rbarbier-p/Harmora/README.md

### Things to improve PCB:

- Tiny Leds for status, power, reading/writing
- expose more pins 
- thicker lines if we have the space
