rbarbier-p/Harmora/presentation.md

Presentation du projet: idees/envies et ce que ca implique
software vs hardware ()
limitation, problemes recontres et solutions (limitation materiel: mcu, library)
ce qu'on a appris (design pcb, realisation d'un cahier des charges, modelisation 3D, decoupe laser, soudure, design d'un produit, realisation d'un projet de 0)
evolution de competences?

Resentit et experience 
ce qu'on souhaite faire plus tard ? / suite du projet ou profesionnalisation

Slide 1: qui/quoi ? -> presentation du projet harmora, et du group rene un etudiant de 42 barcelone qui est venu a paris specialement pour faire ce module.
Slide 2: pourquoi on a choisis ce projet -> theorie musicale (solfege) c'est un domaine assez complique (lie au mathematique et donc  a l'informatique)
-> meme quand on connait la theorie il faut encore beaucoup de pratique pour pouvoir jouer d'un instrument
Slide 3: idea/projet -> notre idee c'est de creer un controlleur midi, et plus precisement un generateur d'accords. Qui permet de facilement jouer des progression d'accord ditent diatonique qui suivent des regles d'harmonie musicale, avec differents instruments. MIDI est une norme et un protocol de communication pour les instrument de musique 
Slide 4: software/hardware -> Notre projet est plutot equilibre entre hardware et software...
Slide 5: problemes/limitations -> pour nous la plus grosse limitation c'est l'utilisation des atmega, RAM limite assez rapidement
Slide 6: ce qu'on a appris -> le design de pcb en utilisant KiCad, ca permet de creer un circuit imprime pour n'importe quel produit/object electronique.
Slide 7: La modelisation 3d qui peut servir pour imprimer en 3D mais aussi pour decouper/engraver avec une decoupeuse laser. C'est tres utile pour tester et prototyper.
Slide 8: autres skills qu'on a appris: la sourdure bien evidement, mais aussi la redaction d'un cahier des charges et on a appris a design un produit de A a Z.
Slide 9: apres le project/suite -> version 2, ameliore ? le commercialiser ?
