rbarbier-p/Harmora/3Dmodels/caseTop4(1).dxf

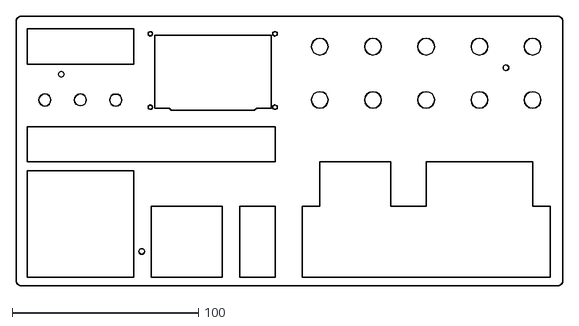
[picture p1: CAD file, 2026-05-14]
3Dmodels/caseTop4(1).dxf
293.7 x 144.7
