rbarbier-p/Harmora/3Dmodels/switch_grid-modes.stl

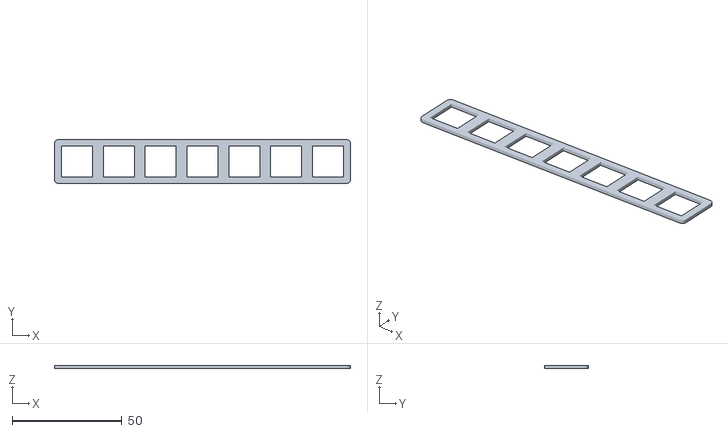
[picture p2: CAD file, 2026-04-30]
3Dmodels/switch_grid-modes.stl
134.8 x 19.9 x 1.50
