rbarbier-p/Harmora/3Dmodels/switch_grid-modifier.stl

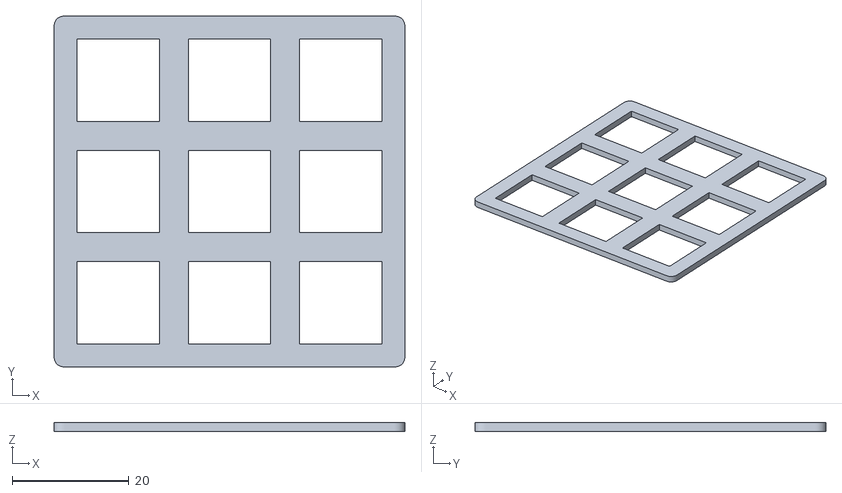
[picture p3: CAD file, 2026-04-30]
3Dmodels/switch_grid-modifier.stl
60.0 x 60.0 x 1.50
