rbarbier-p/Harmora/3Dmodels/case-top.dxf

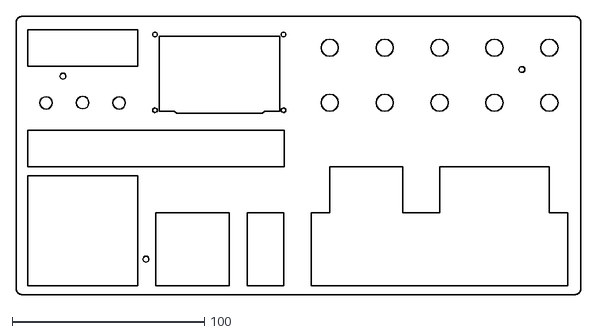
[picture p4: CAD file, 2026-04-30]
3Dmodels/case-top.dxf
293.7 x 144.7
