rbarbier-p/Harmora/3Dmodels/switch_grid-piano.stl

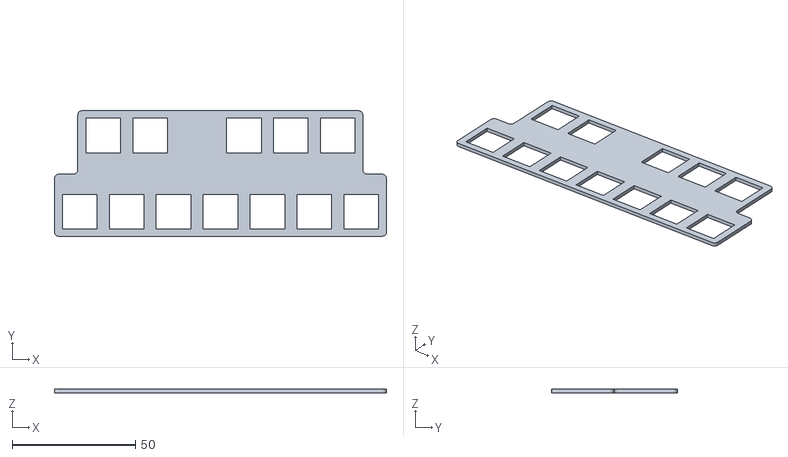
[picture p5: CAD file, 2026-04-30]
3Dmodels/switch_grid-piano.stl
134.8 x 51.0 x 1.50
