rbarbier-p/Harmora/3Dmodels/case-bottom.stl

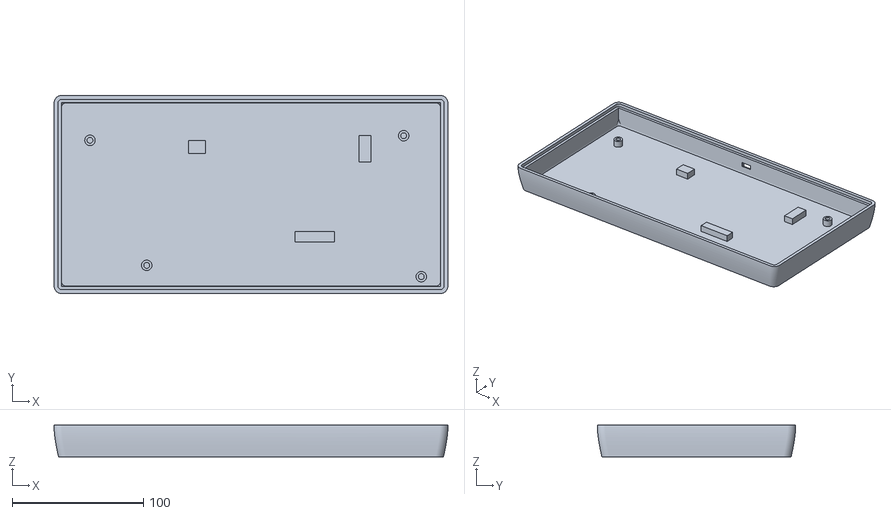
[picture p6: CAD file, 2026-04-30]
3Dmodels/case-bottom.stl
300.0 x 151.0 x 24.0
