rbarbier-p/Harmora/3Dmodels/inner_separators.stl

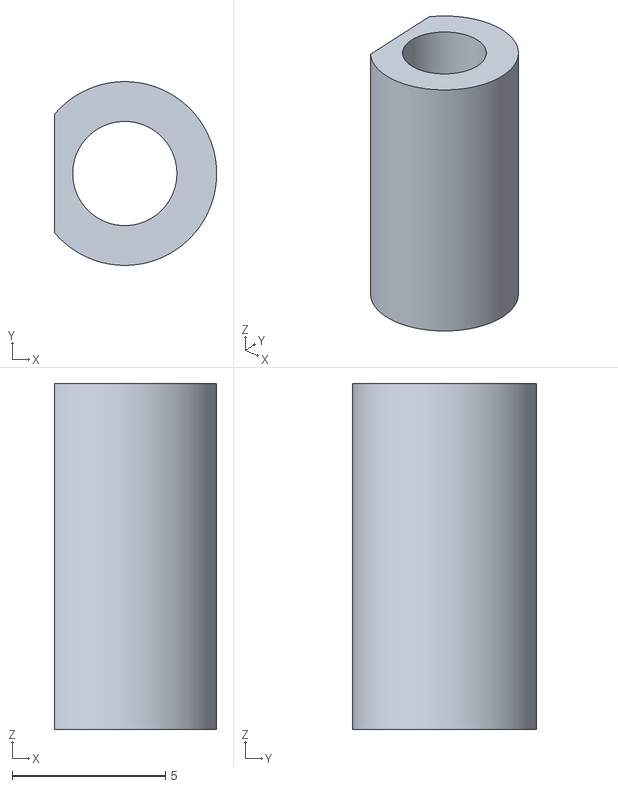
[picture p7: CAD file, 2026-04-30]
3Dmodels/inner_separators.stl
5.30 x 6.00 x 11.3
