rbarbier-p/Harmora/3Dmodels/switch_grid-looper.stl

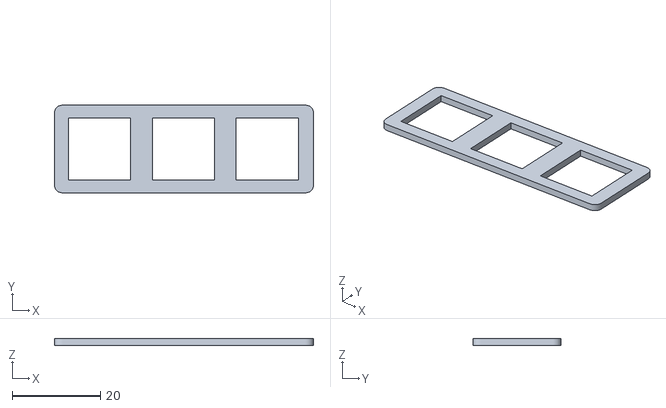
[picture p8: CAD file, 2026-04-30]
3Dmodels/switch_grid-looper.stl
58.9 x 19.9 x 1.50
