rbarbier-p/Harmora/PCB/Harmora.kicad_pcb

## KiCad design PCB/Harmora.kicad_pcb (2026-04-13)

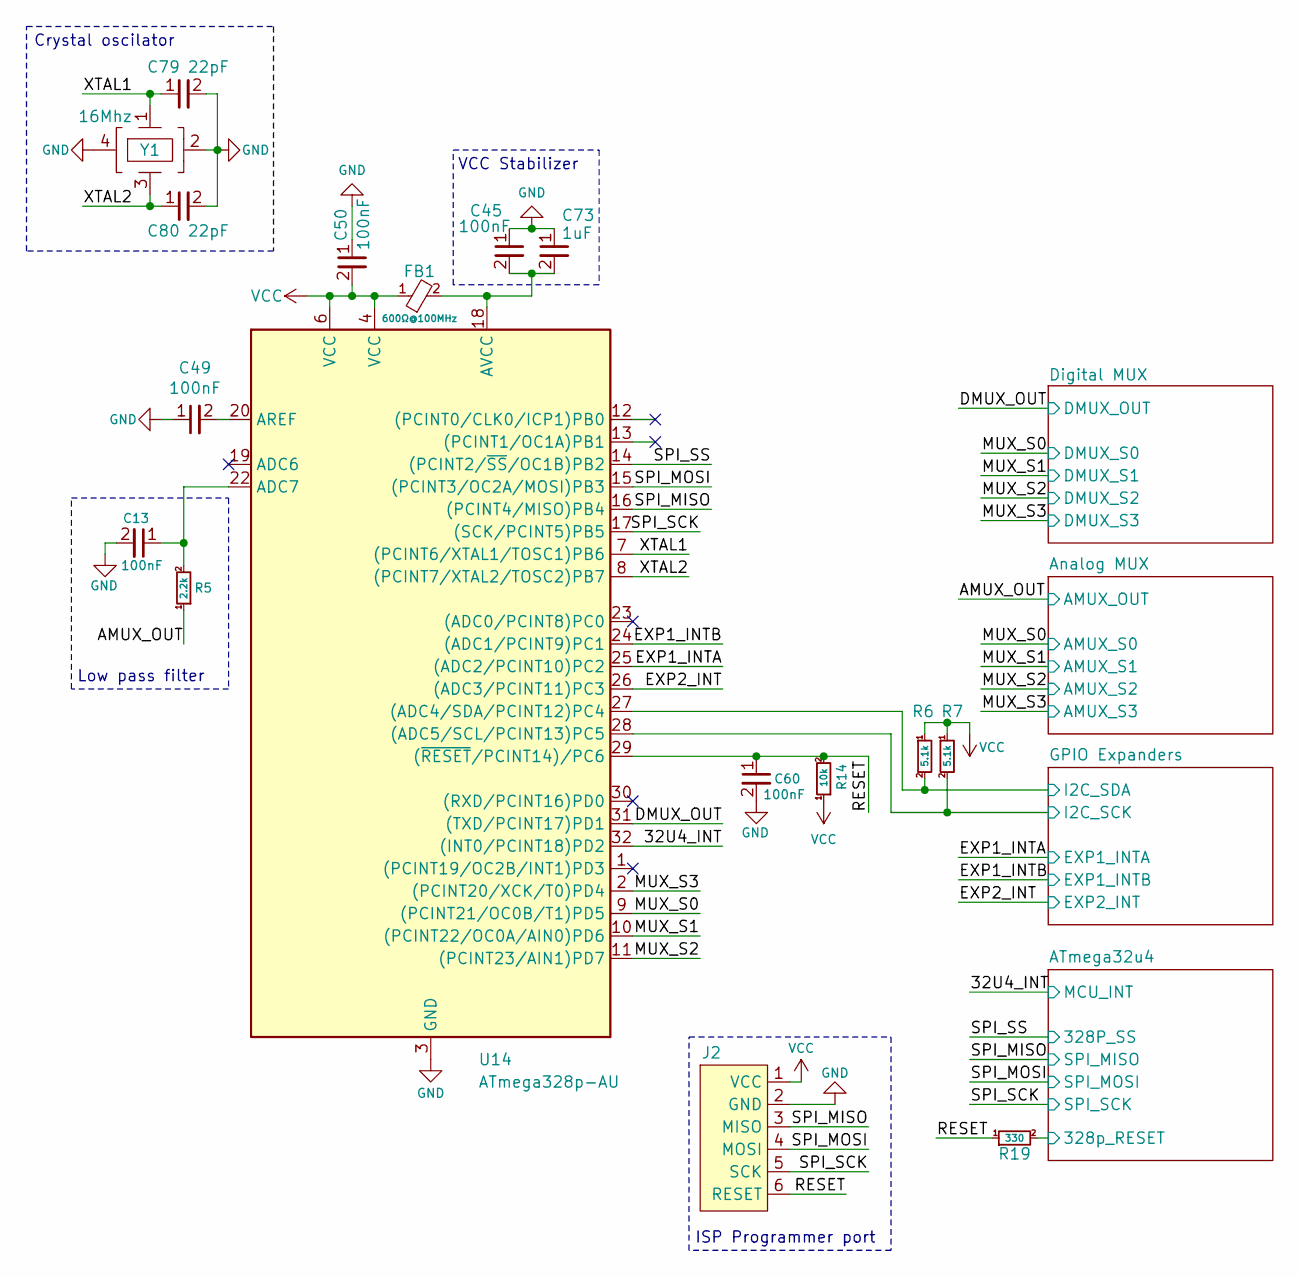
[picture p9: schematic Harmora.kicad_sch]

Parts:
C13, C45, C49, C50, C60: 100nF; 0603_C
C73: 1uF; 0603_C
C79, C80: 22pF; 0603_C
FB1: 600Ω@100MHz; 0603_FB
J2: ISP port
R5: 2.2k; 0603_R
R6, R7: 5.1k; 0603_R
R14: 10k; 0603_R
R19: 330; 0603_R
U14: ATmega328p-AU; ATMEGA328P-AU
Y1: 16Mhz; Crystal Oscillator 16MHz

Connections:
/32U4_INT: U14.32 ((INT0/PCINT18)PD2); also elsewhere on the board
/AMUX_OUT: R5.1; also elsewhere on the board
/ATmega32u4/328p_RESET: R19.2; also elsewhere on the board
/DMUX_OUT: U14.31 ((TXD/PCINT17)PD1); also elsewhere on the board
/EXP1_INTA: U14.25 ((ADC2/PCINT10)PC2); also elsewhere on the board
/EXP1_INTB: U14.24 ((ADC1/PCINT9)PC1); also elsewhere on the board
/EXP2_INT: U14.26 ((ADC3/PCINT11)PC3); also elsewhere on the board
/GPIO Expanders/I2C_SCK: R7.2, U14.28 ((ADC5/SCL/PCINT13)PC5); also elsewhere on the board
/GPIO Expanders/I2C_SDA: R6.2, U14.27 ((ADC4/SDA/PCINT12)PC4); also elsewhere on the board
/MUX_S0: U14.9 ((PCINT21/OC0B/T1)PD5); also elsewhere on the board
/MUX_S1: U14.10 ((PCINT22/OC0A/AIN0)PD6); also elsewhere on the board
/MUX_S2: U14.11 ((PCINT23/AIN1)PD7); also elsewhere on the board
/MUX_S3: U14.2 ((PCINT20/XCK/T0)PD4); also elsewhere on the board
/RESET: C60.1, J2.6 (RESET), R14.2, R19.1, U14.29 ((~RESET/PCINT14)/PC6)
/SPI_MISO: J2.3 (MISO), U14.16 ((PCINT4/MISO)PB4); also elsewhere on the board
/SPI_SS: U14.14 ((PCINT2/~SS/OC1B)PB2); also elsewhere on the board
/XTAL1: C79.1, U14.7 ((PCINT6/XTAL1/TOSC1)PB6), Y1.1
/XTAL2: C80.1, U14.8 ((PCINT7/XTAL2/TOSC2)PB7), Y1.3
GND: C13.2, C45.1, C49.1, C50.1, C60.2, C73.1, C79.2, C80.2, J2.2 (GND), U14.3 (GND), Y1.2, Y1.4; also elsewhere on the board
unnamed: C13.1, R5.2, U14.22 (ADC7)
unnamed: C49.2, U14.20 (AREF)
unnamed: C45.2, C73.2, FB1.2, U14.18 (AVCC)
VCC: C50.2, FB1.1, J2.1 (VCC), R6.1, R7.1, R14.1, U14.4 (VCC), U14.6 (VCC); also elsewhere on the board

Notes on the sheet:
ISP Programmer port
Crystal oscilator
Low pass filter
VCC Stabilizer

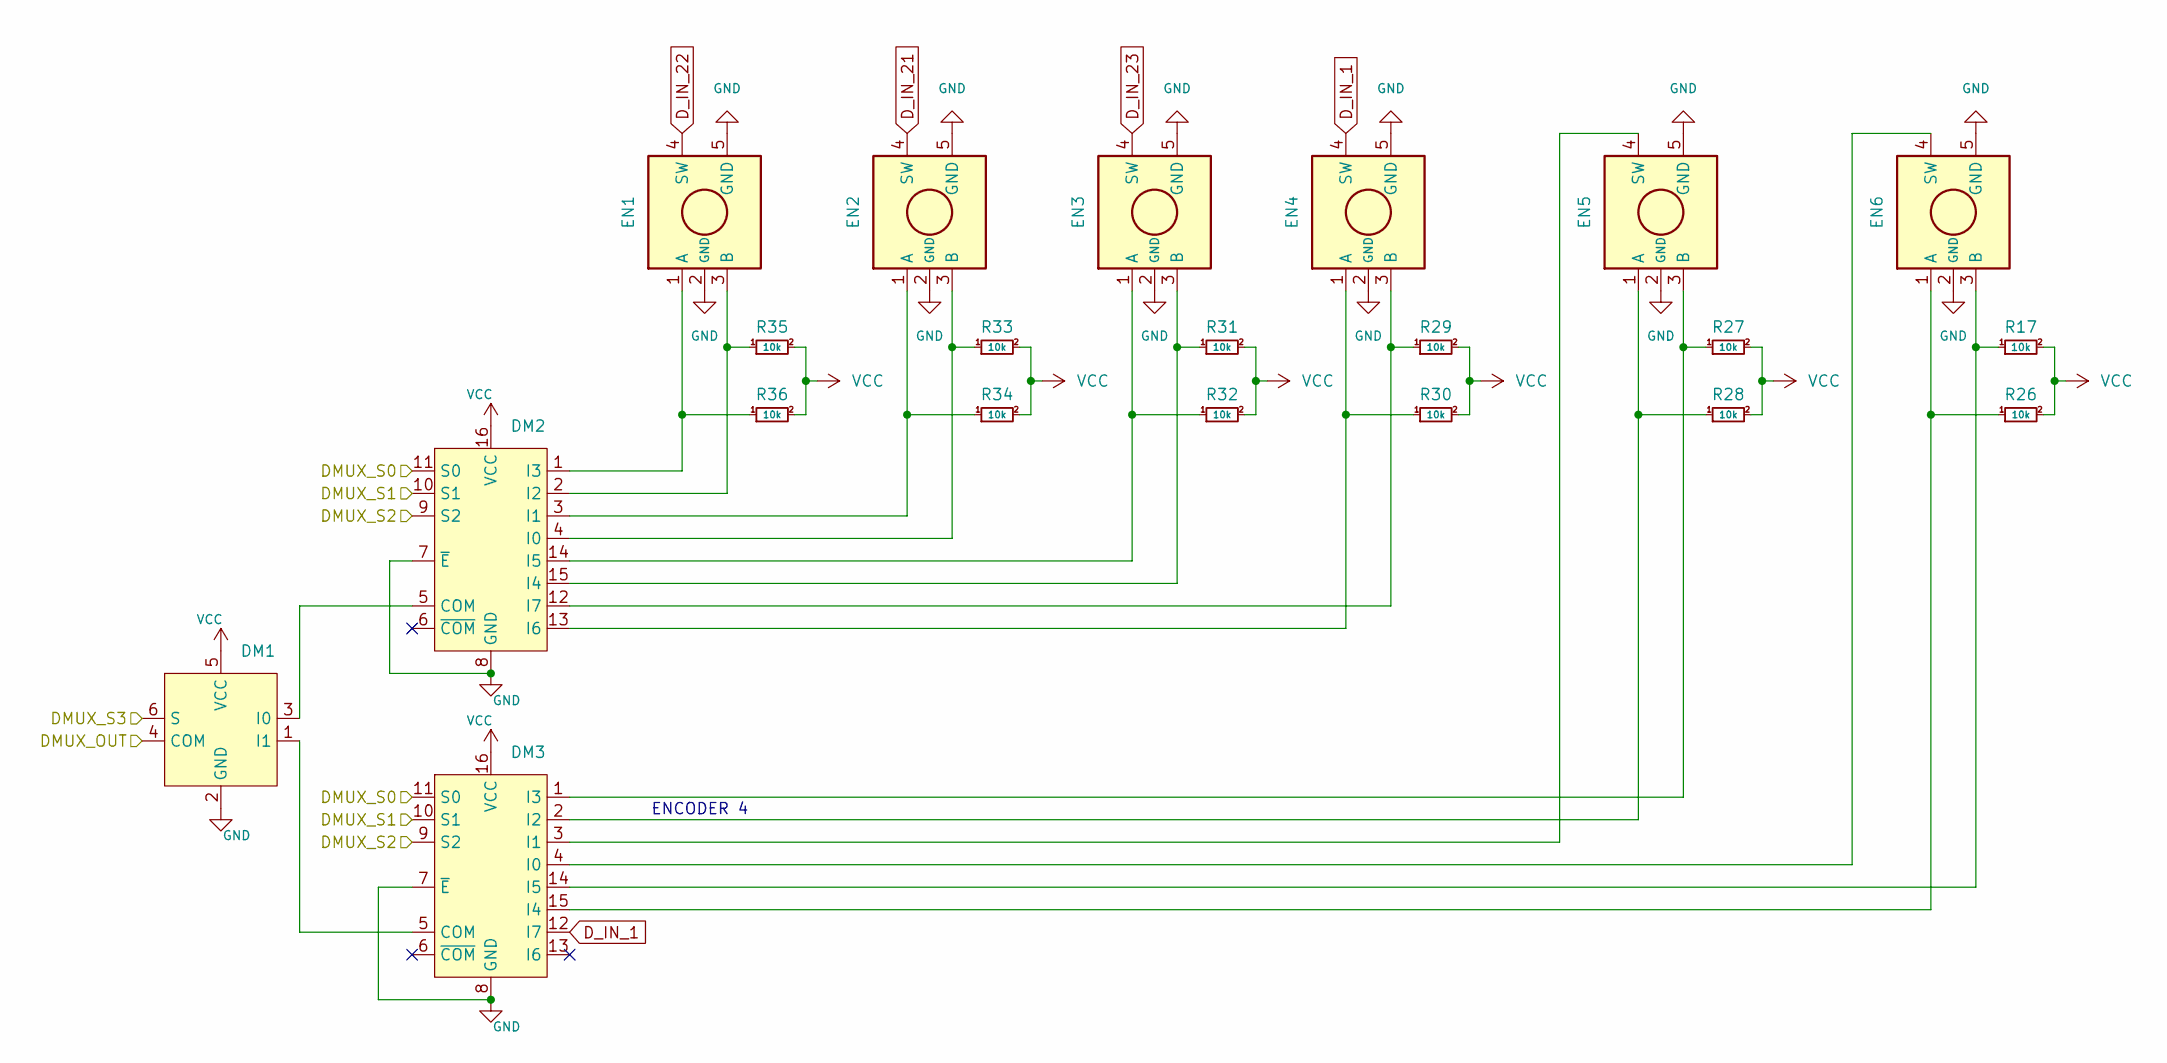
[picture p10: schematic digital_mux.kicad_sch]

Parts:
DM1: 74LVC1G157; 74LVC1G157 SOT-363 2_1 MUX
DM2, DM3: 74AC151SC; 74AC151SC SOIC-16 8_1 MUX
EN1, EN2, EN3, EN4, EN5, EN6: Rotary Encoder EC11E
R17, R26, R27, R28, R29, R30, R31, R32, R33, R34, R35, R36: 10k; 0603_R

Connections:
/DMUX_OUT: DM1.4 (COM); also elsewhere on the board
/MUX_S0: DM2.11 (S0), DM3.11 (S0); also elsewhere on the board
/MUX_S1: DM2.10 (S1), DM3.10 (S1); also elsewhere on the board
/MUX_S2: DM2.9 (S2), DM3.9 (S2); also elsewhere on the board
/MUX_S3: DM1.6 (S); also elsewhere on the board
D_IN_1: DM3.12 (I7), EN4.4 (SW)
D_IN_21: EN2.4 (SW); also elsewhere on the board
D_IN_22: EN1.4 (SW); also elsewhere on the board
D_IN_23: EN3.4 (SW); also elsewhere on the board
GND: DM1.2 (GND), DM2.7 (~E), DM2.8 (GND), DM3.7 (~E), DM3.8 (GND), EN1.2 (GND), EN1.5 (GND), EN2.2 (GND), EN2.5 (GND), EN3.2 (GND), EN3.5 (GND), EN4.2 (GND), EN4.5 (GND), EN5.2 (GND), EN5.5 (GND), EN6.2 (GND), EN6.5 (GND); also elsewhere on the board
unnamed: DM1.3 (I0), DM2.5 (COM)
unnamed: DM1.1 (I1), DM3.5 (COM)
unnamed: DM2.4 (I0), EN2.3 (B), R33.1
unnamed: DM2.3 (I1), EN2.1 (A), R34.1
unnamed: DM2.2 (I2), EN1.3 (B), R35.1
unnamed: DM2.1 (I3), EN1.1 (A), R36.1
unnamed: DM2.15 (I4), EN3.3 (B), R31.1
unnamed: DM2.14 (I5), EN3.1 (A), R32.1
unnamed: DM2.13 (I6), EN4.1 (A), R30.1
unnamed: DM2.12 (I7), EN4.3 (B), R29.1
unnamed: DM3.4 (I0), EN6.4 (SW)
unnamed: DM3.3 (I1), EN5.4 (SW)
unnamed: DM3.2 (I2), EN5.1 (A), R28.1
unnamed: DM3.1 (I3), EN5.3 (B), R27.1
unnamed: DM3.15 (I4), EN6.1 (A), R26.1
unnamed: DM3.14 (I5), EN6.3 (B), R17.1
VCC: DM1.5 (VCC), DM2.16 (VCC), DM3.16 (VCC), R17.2, R26.2, R27.2, R28.2, R29.2, R30.2, R31.2, R32.2, R33.2, R34.2, R35.2, R36.2; also elsewhere on the board

Notes on the sheet:
ENCODER 4

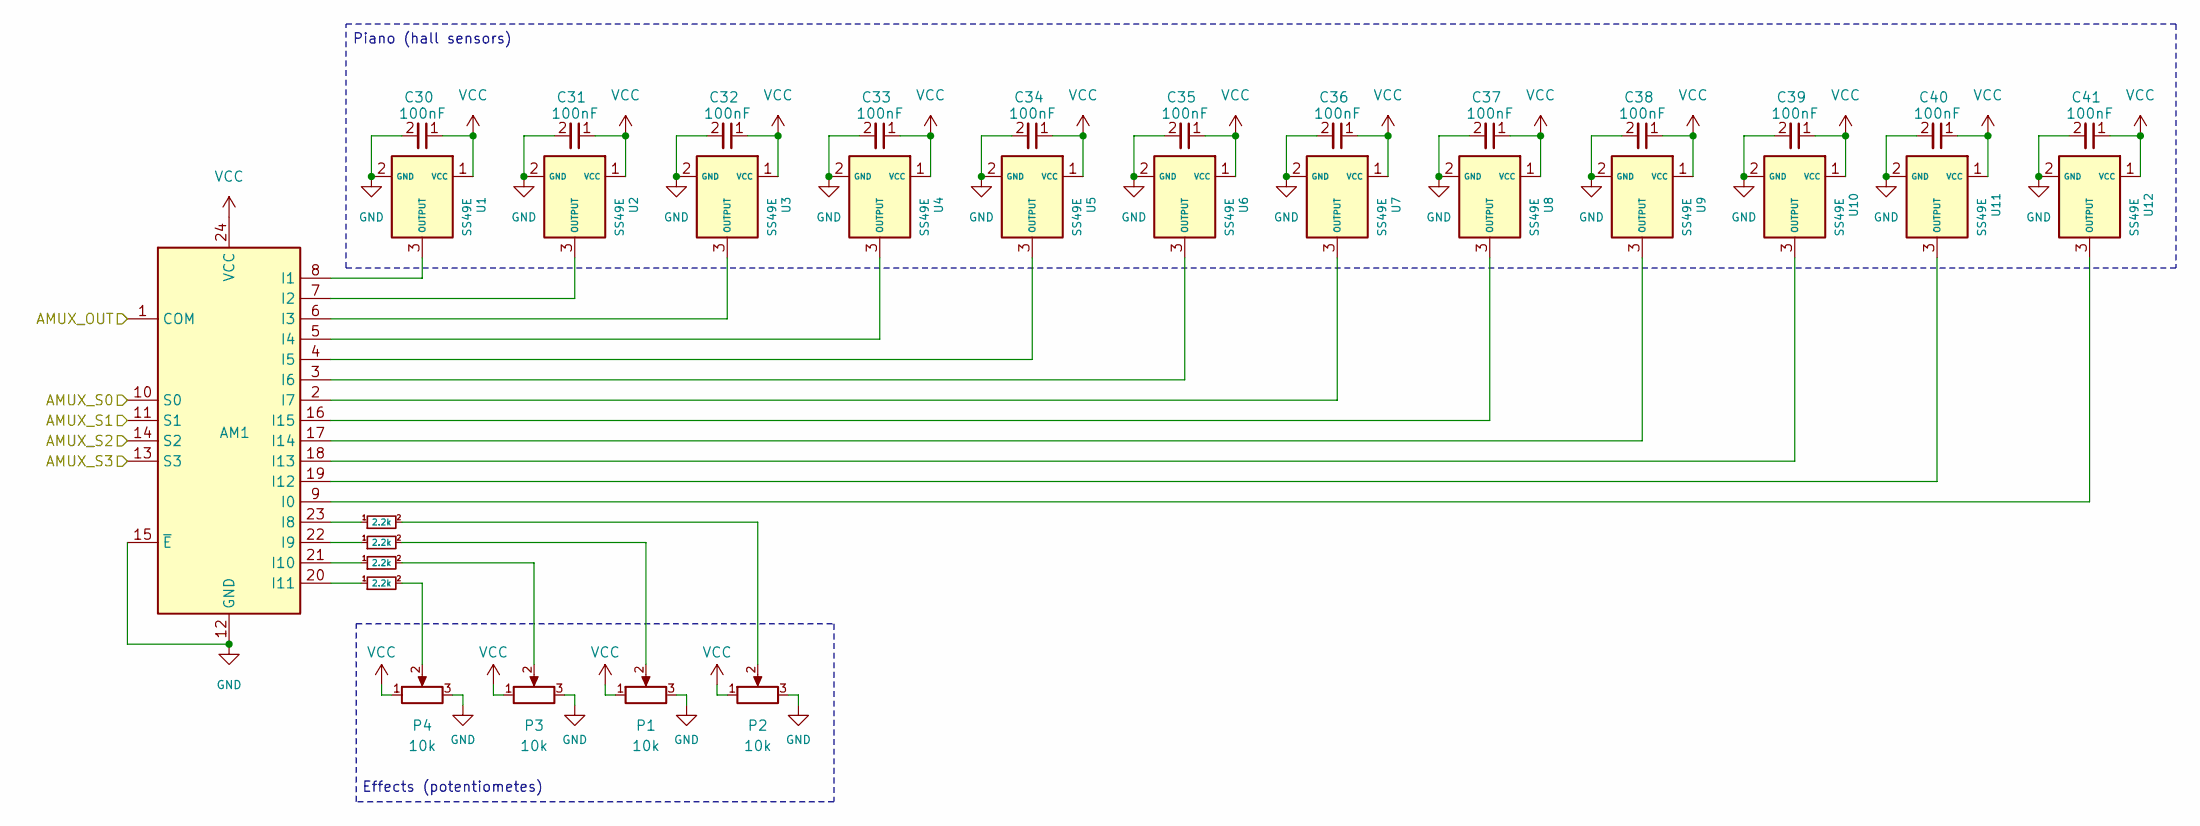
[picture p11: schematic analog_mux.kicad_sch]

Parts:
AM1: CD74HC4067M; CD74HC4067M Analog Mux (SOIC-24)
C30, C31, C32, C33, C34, C35, C36, C37, C38, C39, C40, C41: 100nF; 0603_C
P1, P2, P3, P4: 10k; Rotary Potentiometer RK09
R1, R2, R3, R4: 2.2k; 0603_R
U1, U2, U3, U4, U5, U6, U7, U8, U9, U10, U11, U12: SS49E; SLSS49E-3 Hall Sensor (SOT-23-3)

Connections:
/AMUX_OUT: AM1.1 (COM); also elsewhere on the board
/MUX_S0: AM1.10 (S0); also elsewhere on the board
/MUX_S1: AM1.11 (S1); also elsewhere on the board
/MUX_S2: AM1.14 (S2); also elsewhere on the board
/MUX_S3: AM1.13 (S3); also elsewhere on the board
GND: AM1.12 (GND), AM1.15 (~E), C30.2, C31.2, C32.2, C33.2, C34.2, C35.2, C36.2, C37.2, C38.2, C39.2, C40.2, C41.2, P1.3, P2.3, P3.3, P4.3, U1.2 (GND), U2.2 (GND), U3.2 (GND), U4.2 (GND), U5.2 (GND), U6.2 (GND), U7.2 (GND), U8.2 (GND), U9.2 (GND), U10.2 (GND), U11.2 (GND), U12.2 (GND); also elsewhere on the board
unnamed: AM1.9 (I0), U12.3 (OUTPUT)
unnamed: AM1.8 (I1), U1.3 (OUTPUT)
unnamed: AM1.7 (I2), U2.3 (OUTPUT)
unnamed: AM1.6 (I3), U3.3 (OUTPUT)
unnamed: AM1.5 (I4), U4.3 (OUTPUT)
unnamed: AM1.4 (I5), U5.3 (OUTPUT)
unnamed: AM1.3 (I6), U6.3 (OUTPUT)
unnamed: AM1.2 (I7), U7.3 (OUTPUT)
unnamed: AM1.23 (I8), R4.1
unnamed: AM1.22 (I9), R3.1
unnamed: AM1.21 (I10), R2.1
unnamed: AM1.20 (I11), R1.1
unnamed: AM1.19 (I12), U11.3 (OUTPUT)
unnamed: AM1.18 (I13), U10.3 (OUTPUT)
unnamed: AM1.17 (I14), U9.3 (OUTPUT)
unnamed: AM1.16 (I15), U8.3 (OUTPUT)
unnamed: P1.2, R3.2
unnamed: P2.2, R4.2
unnamed: P3.2, R2.2
unnamed: P4.2, R1.2
VCC: AM1.24 (VCC), C30.1, C31.1, C32.1, C33.1, C34.1, C35.1, C36.1, C37.1, C38.1, C39.1, C40.1, C41.1, P1.1, P2.1, P3.1, P4.1, U1.1 (VCC), U2.1 (VCC), U3.1 (VCC), U4.1 (VCC), U5.1 (VCC), U6.1 (VCC), U7.1 (VCC), U8.1 (VCC), U9.1 (VCC), U10.1 (VCC), U11.1 (VCC), U12.1 (VCC); also elsewhere on the board

Notes on the sheet:
Piano (hall sensors)
Effects (potentiometes)

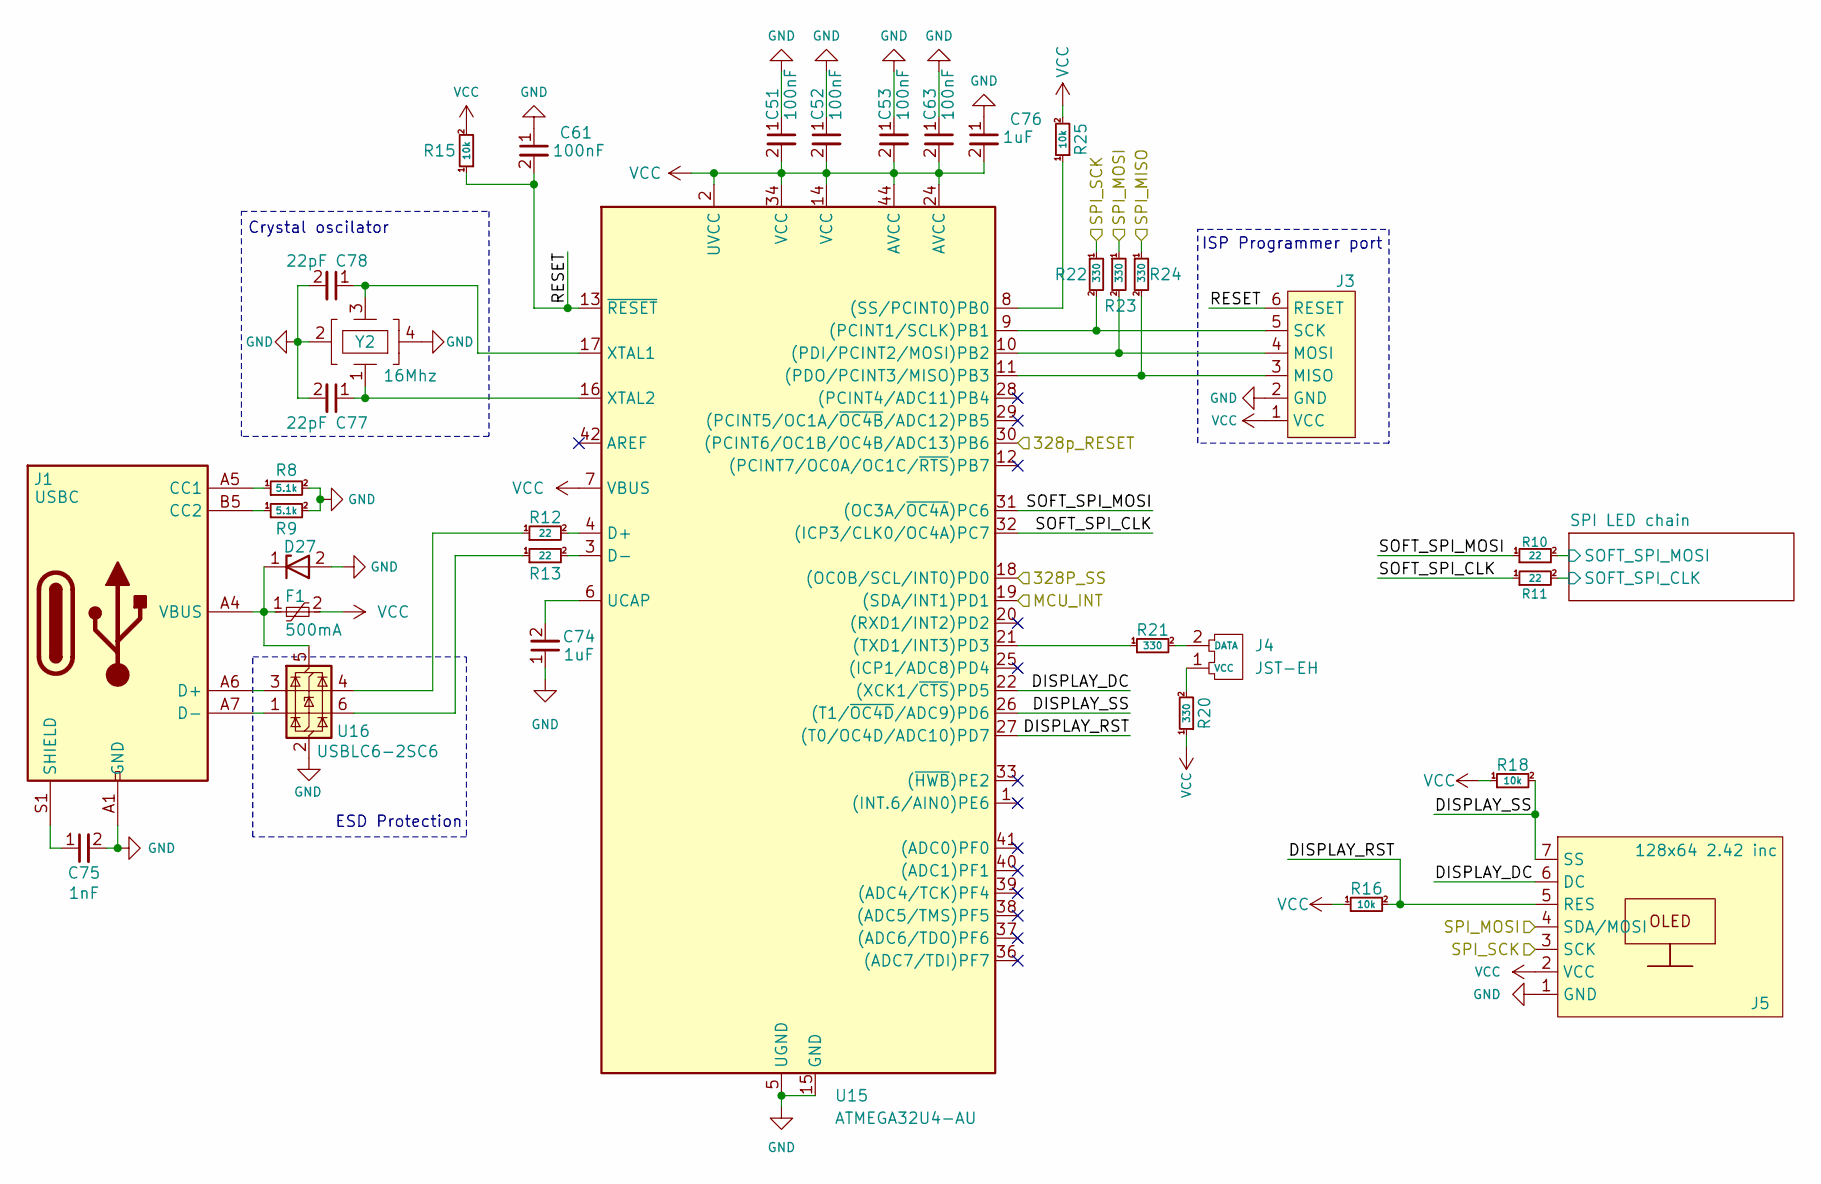
[picture p12: schematic MCU_32u4.kicad_sch]

Parts:
C51, C52, C53, C61, C63: 100nF; 0603_C
C74, C76: 1uF; 0603_C
C75: 1nF; 0603_C
C77, C78: 22pF; 0603_C
D27: TVS Diode SOD-123FL
F1: 500mA; Resettable Fuse 1206
J1: USBC; USB C Receptacle USB2.0 16PIN
J3: ISP port
J4: JST-EH; JST-EH port
J5: 128x64 2.42 inc; SPI Screen PinHeader
R8, R9: 5.1k; 0603_R
R10, R11, R12, R13: 22; 0603_R
R15, R16, R18, R25: 10k; 0603_R
R20, R21, R22, R23, R24: 330; 0603_R
U15: ATMEGA32U4-AU
U16: USBLC6-2SC6; ESD Prot SOT-23-6
Y2: 16Mhz; Crystal Oscillator 16MHz

Connections:
/32U4_INT: U15.19 ((SDA/INT1)PD1); also elsewhere on the board
/ATmega32u4/328p_RESET: U15.30 ((PCINT6/OC1B/OC4B/ADC13)PB6); also elsewhere on the board
/ATmega32u4/DISPLAY_DC: J5.6 (DC), U15.22 ((XCK1/~CTS)PD5)
/ATmega32u4/DISPLAY_RST: J5.5 (RES), R16.2, U15.27 ((T0/OC4D/ADC10)PD7)
/ATmega32u4/DISPLAY_SS: J5.7 (SS), R18.2, U15.26 ((T1/~OC4D/ADC9)PD6)
/ATmega32u4/RESET: C61.2, J3.6 (RESET), R15.1, U15.13 (~RESET)
/ATmega32u4/SOFT_SPI_CLK: R11.1, U15.32 ((ICP3/CLK0/OC4A)PC7)
/ATmega32u4/SOFT_SPI_MOSI: R10.1, U15.31 ((OC3A/~OC4A)PC6)
/ATmega32u4/SPI LED chain/SOFT_SPI_CLK: R11.2; also elsewhere on the board
/ATmega32u4/SPI LED chain/SOFT_SPI_MOSI: R10.2; also elsewhere on the board
/SPI_MISO: R24.1; also elsewhere on the board
/SPI_SS: U15.18 ((OC0B/SCL/INT0)PD0); also elsewhere on the board
GND: C51.1, C52.1, C53.1, C61.1, C63.1, C74.1, C75.2, C76.1, C77.2, C78.2, D27.2, J1.A1 (GND), J1.A12 (GND), J1.B1 (GND), J1.B12 (GND), J3.2 (GND), J5.1 (GND), R8.2, R9.2, U15.5 (UGND), U15.15 (GND), U16.2 (GND), Y2.2, Y2.4; also elsewhere on the board
unnamed: J1.A5 (CC1), R8.1
unnamed: J1.B5 (CC2), R9.1
unnamed: J1.A6 (D+), U16.3 (I/O1)
unnamed: J1.A7 (D-), U16.1 (I/O2)
unnamed: C75.1, J1.S1 (SHIELD)
unnamed: D27.1, F1.1, J1.A4 (VBUS), U16.5 (VBUS)
unnamed: J3.3 (MISO), R24.2, U15.11 ((PDO/PCINT3/MISO)PB3)
unnamed: J4.2 (DATA), R21.2
unnamed: J4.1 (VCC), R20.2
unnamed: R12.1, U16.4 (I/O1)
unnamed: R13.1, U16.6 (I/O2)
unnamed: R25.1, U15.8 ((SS/PCINT0)PB0)
unnamed: R21.1, U15.21 ((TXD1/INT3)PD3)
unnamed: R12.2, U15.4 (D+)
unnamed: R13.2, U15.3 (D-)
unnamed: C74.2, U15.6 (UCAP)
unnamed: C78.1, U15.17 (XTAL1), Y2.3
unnamed: C77.1, U15.16 (XTAL2), Y2.1
VCC: C51.2, C52.2, C53.2, C63.2, C76.2, F1.2, J3.1 (VCC), J5.2 (VCC), R15.2, R16.1, R18.1, R20.1, R25.2, U15.2 (UVCC), U15.7 (VBUS), U15.14 (VCC), U15.24 (AVCC), U15.34 (VCC), U15.44 (AVCC); also elsewhere on the board

Notes on the sheet:
ISP Programmer port
ESD Protection
Crystal oscilator

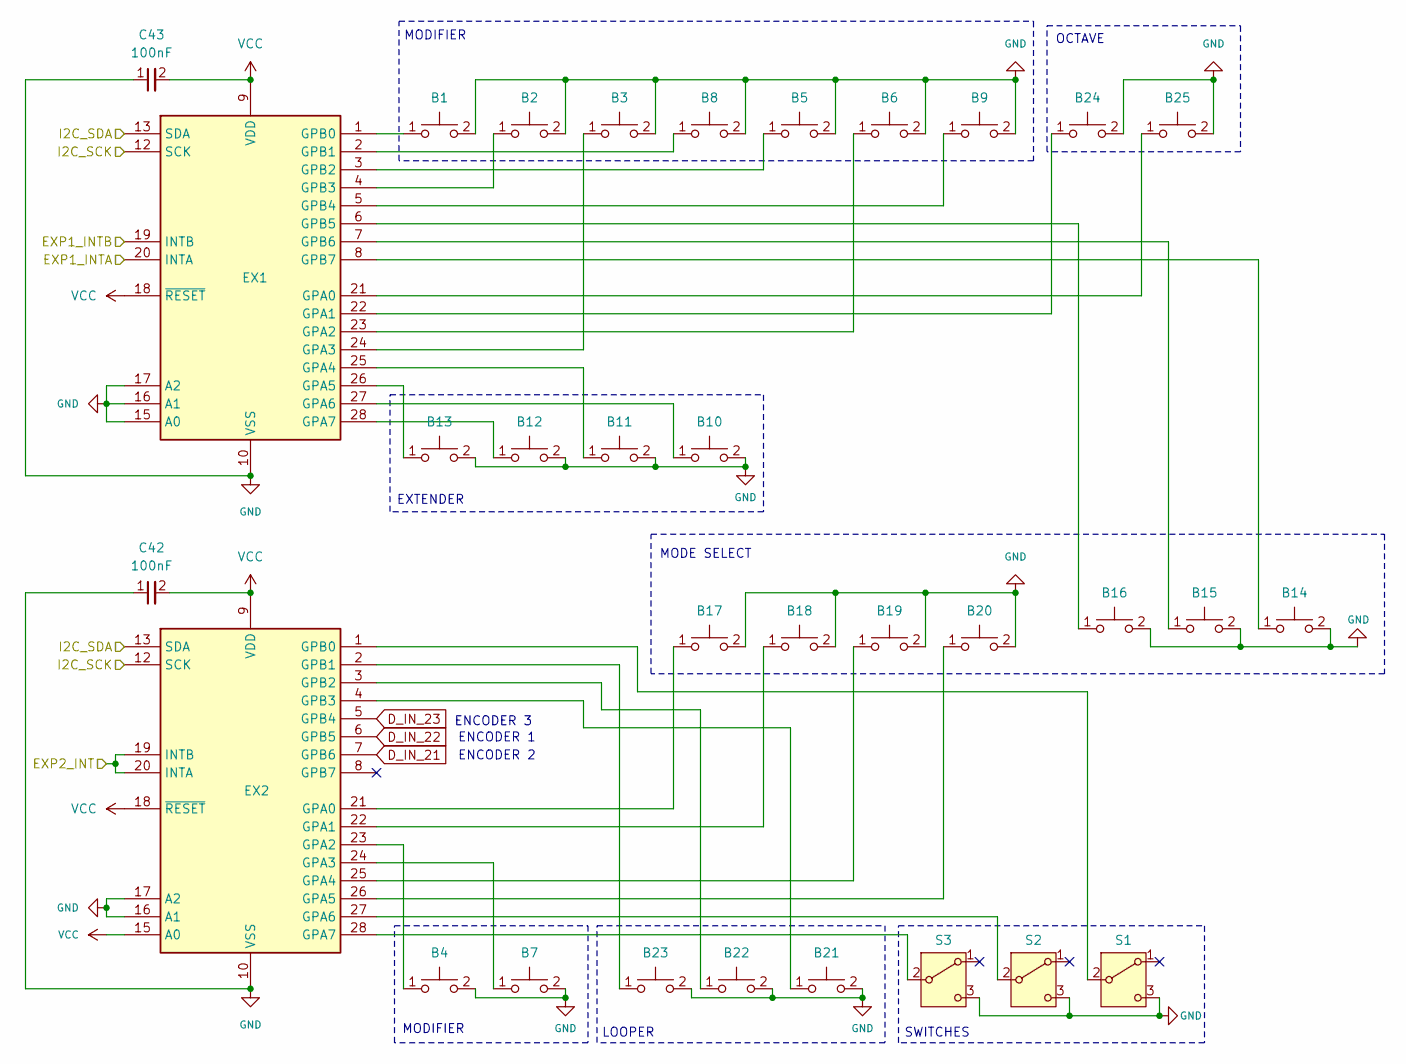
[picture p13: schematic expanders.kicad_sch]

Parts:
B1, B2, B3, B4, B5, B6, B7, B8, B9, B10, B11, B12, B13, B14, B15, B16, B17, B18, B19, B20, B21, B22, B23, B24, B25: Mechanical Switch
C42, C43: 100nF; 0603_C
EX1, EX2: MCP23017 GPIO Expander
S1, S2, S3: MTS-102 Switch

Connections:
/EXP1_INTA: EX1.20 (INTA); also elsewhere on the board
/EXP1_INTB: EX1.19 (INTB); also elsewhere on the board
/EXP2_INT: EX2.19 (INTB), EX2.20 (INTA); also elsewhere on the board
/GPIO Expanders/I2C_SCK: EX1.12 (SCK), EX2.12 (SCK); also elsewhere on the board
/GPIO Expanders/I2C_SDA: EX1.13 (SDA), EX2.13 (SDA); also elsewhere on the board
D_IN_21: EX2.7 (GPB6); also elsewhere on the board
D_IN_22: EX2.6 (GPB5); also elsewhere on the board
D_IN_23: EX2.5 (GPB4); also elsewhere on the board
GND: B1.2, B2.2, B3.2, B4.2, B5.2, B6.2, B7.2, B8.2, B9.2, B10.2, B11.2, B12.2, B13.2, B14.2, B15.2, B16.2, B17.2, B18.2, B19.2, B20.2, B21.2, B22.2, B23.2, B24.2, B25.2, C42.1, C43.1, EX1.10 (VSS), EX1.15 (A0), EX1.16 (A1), EX1.17 (A2), EX2.10 (VSS), EX2.16 (A1), EX2.17 (A2), S1.3, S2.3, S3.3; also elsewhere on the board
unnamed: B25.1, EX1.21 (GPA0)
unnamed: B24.1, EX1.22 (GPA1)
unnamed: B6.1, EX1.23 (GPA2)
unnamed: B3.1, EX1.24 (GPA3)
unnamed: B11.1, EX1.25 (GPA4)
unnamed: B13.1, EX1.26 (GPA5)
unnamed: B10.1, EX1.27 (GPA6)
unnamed: B12.1, EX1.28 (GPA7)
unnamed: B1.1, EX1.1 (GPB0)
unnamed: B8.1, EX1.2 (GPB1)
unnamed: B5.1, EX1.3 (GPB2)
unnamed: B2.1, EX1.4 (GPB3)
unnamed: B9.1, EX1.5 (GPB4)
unnamed: B16.1, EX1.6 (GPB5)
unnamed: B15.1, EX1.7 (GPB6)
unnamed: B14.1, EX1.8 (GPB7)
unnamed: B17.1, EX2.21 (GPA0)
unnamed: B18.1, EX2.22 (GPA1)
unnamed: B4.1, EX2.23 (GPA2)
unnamed: B7.1, EX2.24 (GPA3)
unnamed: B19.1, EX2.25 (GPA4)
unnamed: B20.1, EX2.26 (GPA5)
unnamed: EX2.27 (GPA6), S2.2
unnamed: EX2.28 (GPA7), S3.2
unnamed: EX2.1 (GPB0), S1.2
unnamed: B23.1, EX2.2 (GPB1)
unnamed: B22.1, EX2.3 (GPB2)
unnamed: B21.1, EX2.4 (GPB3)
VCC: C42.2, C43.2, EX1.9 (VDD), EX1.18 (~RESET), EX2.9 (VDD), EX2.15 (A0), EX2.18 (~RESET); also elsewhere on the board

Notes on the sheet:
ENCODER 1
LOOPER
MODIFIER
MODE SELECT
EXTENDER
SWITCHES
ENCODER 2
ENCODER 3
OCTAVE

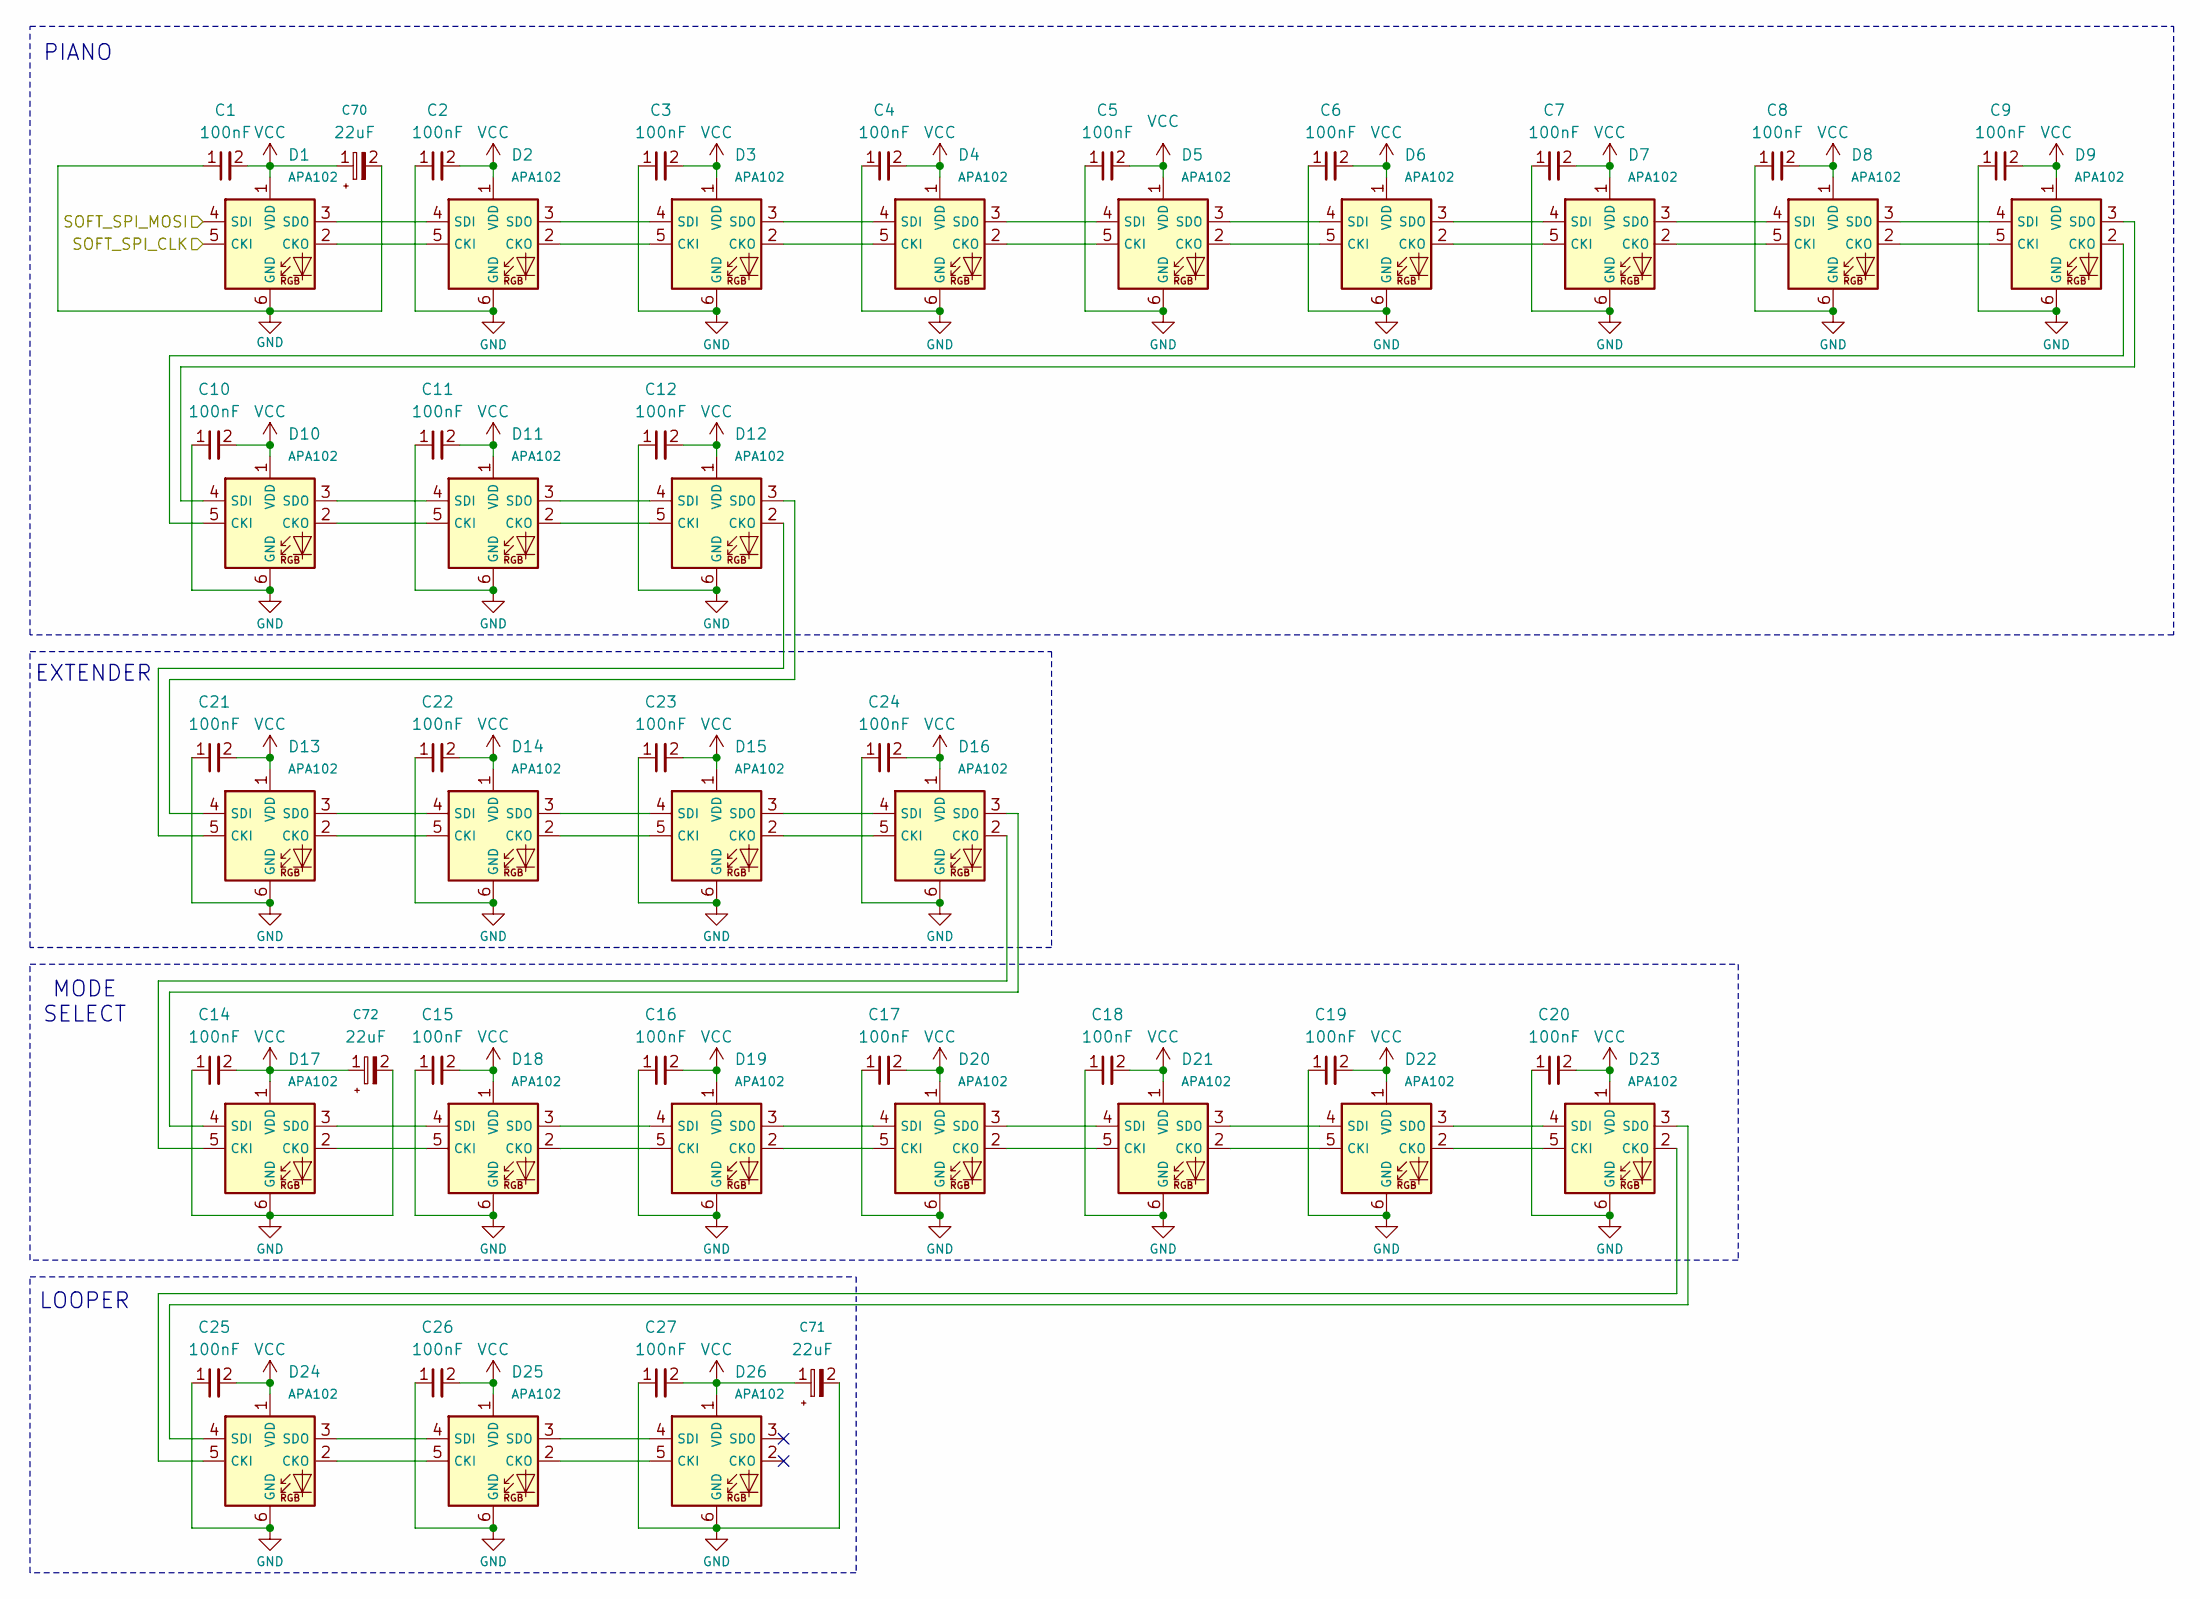
[picture p14: schematic SPI_LED_chain.kicad_sch]

Parts:
C1, C2, C3, C4, C5, C6, C7, C8, C9, C10, C11, C12, C14, C15, C16, C17, C18, C19, C20, C21, C22, C23, C24, C25, C26, C27: 100nF; 0603_C
C70, C71, C72: 22uF; C_Electrolytic_4x5.4
D1, D2, D3, D4, D5, D6, D7, D8, D9, D10, D11, D12, D13, D14, D15, D16, D17, D18, D19, D20, D21, D22, D23, D24, D25, D26: APA102; APA102 LED

Connections:
/ATmega32u4/SPI LED chain/SOFT_SPI_CLK: D1.5 (CKI); also elsewhere on the board
/ATmega32u4/SPI LED chain/SOFT_SPI_MOSI: D1.4 (SDI); also elsewhere on the board
GND: C1.1, C2.1, C3.1, C4.1, C5.1, C6.1, C7.1, C8.1, C9.1, C10.1, C11.1, C12.1, C14.1, C15.1, C16.1, C17.1, C18.1, C19.1, C20.1, C21.1, C22.1, C23.1, C24.1, C25.1, C26.1, C27.1, C70.2, C71.2, C72.2, D1.6 (GND), D2.6 (GND), D3.6 (GND), D4.6 (GND), D5.6 (GND), D6.6 (GND), D7.6 (GND), D8.6 (GND), D9.6 (GND), D10.6 (GND), D11.6 (GND), D12.6 (GND), D13.6 (GND), D14.6 (GND), D15.6 (GND), D16.6 (GND), D17.6 (GND), D18.6 (GND), D19.6 (GND), D20.6 (GND), D21.6 (GND), D22.6 (GND), D23.6 (GND), D24.6 (GND), D25.6 (GND), D26.6 (GND); also elsewhere on the board
unnamed: D1.2 (CKO), D2.5 (CKI)
unnamed: D1.3 (SDO), D2.4 (SDI)
unnamed: D2.2 (CKO), D3.5 (CKI)
unnamed: D2.3 (SDO), D3.4 (SDI)
unnamed: D3.2 (CKO), D4.5 (CKI)
unnamed: D3.3 (SDO), D4.4 (SDI)
unnamed: D4.2 (CKO), D5.5 (CKI)
unnamed: D4.3 (SDO), D5.4 (SDI)
unnamed: D5.2 (CKO), D6.5 (CKI)
unnamed: D5.3 (SDO), D6.4 (SDI)
unnamed: D6.2 (CKO), D7.5 (CKI)
unnamed: D6.3 (SDO), D7.4 (SDI)
unnamed: D7.2 (CKO), D8.5 (CKI)
unnamed: D7.3 (SDO), D8.4 (SDI)
unnamed: D8.2 (CKO), D9.5 (CKI)
unnamed: D8.3 (SDO), D9.4 (SDI)
unnamed: D9.2 (CKO), D10.5 (CKI)
unnamed: D10.2 (CKO), D11.5 (CKI)
unnamed: D9.3 (SDO), D10.4 (SDI)
unnamed: D10.3 (SDO), D11.4 (SDI)
unnamed: D11.2 (CKO), D12.5 (CKI)
unnamed: D11.3 (SDO), D12.4 (SDI)
unnamed: D12.2 (CKO), D13.5 (CKI)
unnamed: D12.3 (SDO), D13.4 (SDI)
unnamed: D13.2 (CKO), D14.5 (CKI)
unnamed: D13.3 (SDO), D14.4 (SDI)
unnamed: D14.2 (CKO), D15.5 (CKI)
unnamed: D14.3 (SDO), D15.4 (SDI)
unnamed: D15.2 (CKO), D16.5 (CKI)
unnamed: D15.3 (SDO), D16.4 (SDI)
unnamed: D16.2 (CKO), D17.5 (CKI)
unnamed: D16.3 (SDO), D17.4 (SDI)
unnamed: D17.2 (CKO), D18.5 (CKI)
unnamed: D17.3 (SDO), D18.4 (SDI)
unnamed: D18.2 (CKO), D19.5 (CKI)
unnamed: D18.3 (SDO), D19.4 (SDI)
unnamed: D19.2 (CKO), D20.5 (CKI)
unnamed: D19.3 (SDO), D20.4 (SDI)
unnamed: D20.2 (CKO), D21.5 (CKI)
unnamed: D20.3 (SDO), D21.4 (SDI)
unnamed: D21.2 (CKO), D22.5 (CKI)
unnamed: D21.3 (SDO), D22.4 (SDI)
unnamed: D22.2 (CKO), D23.5 (CKI)
unnamed: D22.3 (SDO), D23.4 (SDI)
unnamed: D23.2 (CKO), D24.5 (CKI)
unnamed: D23.3 (SDO), D24.4 (SDI)
unnamed: D24.2 (CKO), D25.5 (CKI)
unnamed: D24.3 (SDO), D25.4 (SDI)
unnamed: D25.2 (CKO), D26.5 (CKI)
unnamed: D25.3 (SDO), D26.4 (SDI)
VCC: C1.2, C2.2, C3.2, C4.2, C5.2, C6.2, C7.2, C8.2, C9.2, C10.2, C11.2, C12.2, C14.2, C15.2, C16.2, C17.2, C18.2, C19.2, C20.2, C21.2, C22.2, C23.2, C24.2, C25.2, C26.2, C27.2, C70.1, C71.1, C72.1, D1.1 (VDD), D2.1 (VDD), D3.1 (VDD), D4.1 (VDD), D5.1 (VDD), D6.1 (VDD), D7.1 (VDD), D8.1 (VDD), D9.1 (VDD), D10.1 (VDD), D11.1 (VDD), D12.1 (VDD), D13.1 (VDD), D14.1 (VDD), D15.1 (VDD), D16.1 (VDD), D17.1 (VDD), D18.1 (VDD), D19.1 (VDD), D20.1 (VDD), D21.1 (VDD), D22.1 (VDD), D23.1 (VDD), D24.1 (VDD), D25.1 (VDD), D26.1 (VDD); also elsewhere on the board

Notes on the sheet:
MODE SELECT
PIANO
LOOPER
EXTENDER

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
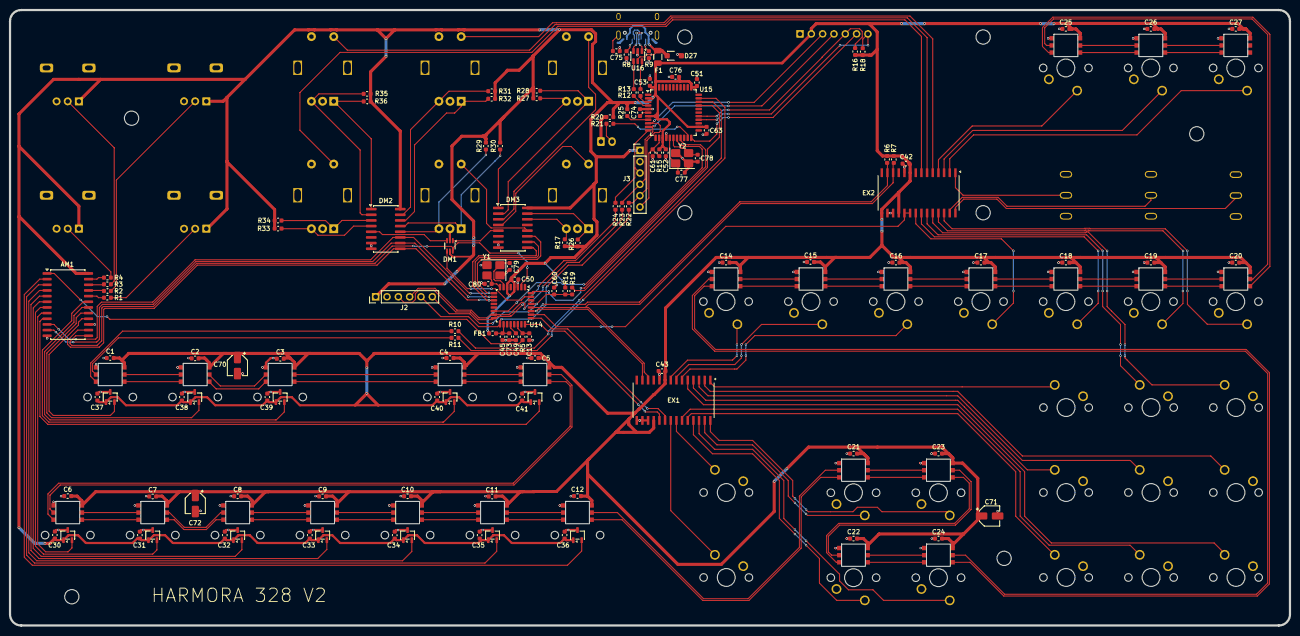
[picture p15: board Harmora.kicad_pcb from above]

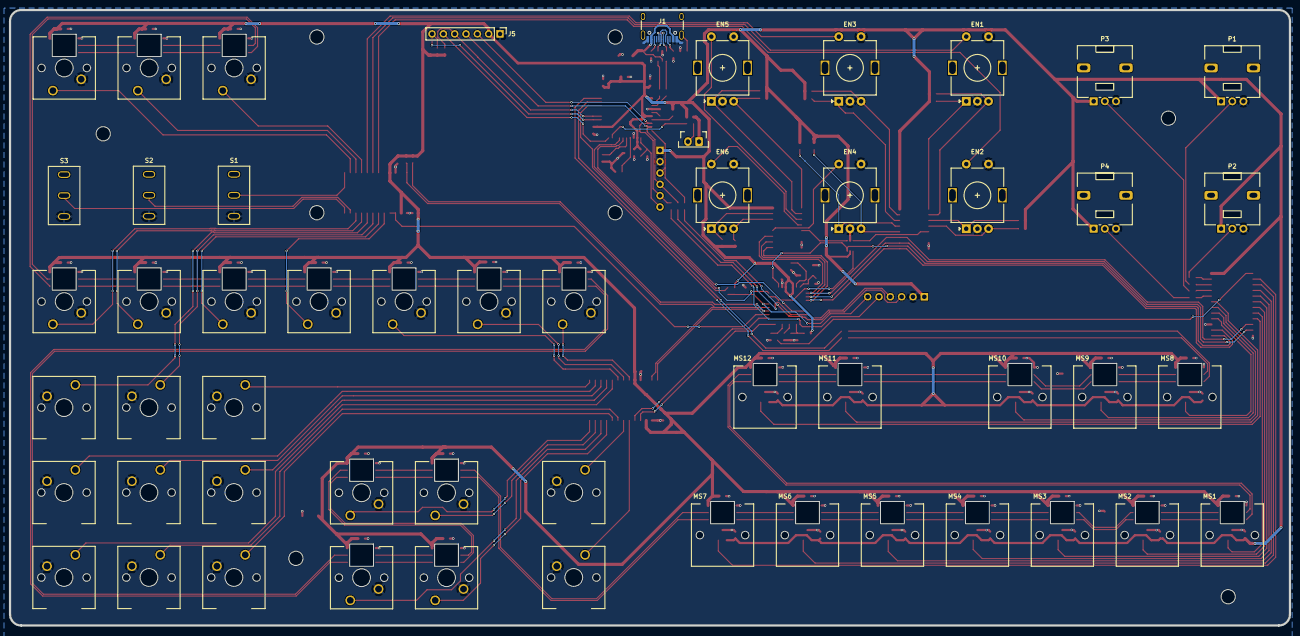
[picture p16: board Harmora.kicad_pcb from below]

Board: 2 copper layers, 287.0 x 138.0 mm, 192 parts (41 on the bottom side), 169 nets.
