rbarbier-p/Harmora/code/src/328p/expander/expander.c

#include "expander.h"
#include "mcp23017.h"
#include "../pins.h"
#include <util/delay.h>

// Module State

static mcp23017_t g_expander[2];

// Interrupt Pin Configuration (ATmega328P)

static void expander_init_int_pins(void) {
  // Configure interrupt pins as inputs with pull-ups
  // (MCP23017 INT pins are open-drain by default)

  GPIO_SET_INPUT(PIN_EXP1_INTA);
  GPIO_SET_INPUT(PIN_EXP1_INTB);
  GPIO_SET_INPUT(PIN_EXP2_INT);
  
  GPIO_ENABLE_PULLUP(PIN_EXP1_INTA);
  GPIO_ENABLE_PULLUP(PIN_EXP1_INTB);
  GPIO_ENABLE_PULLUP(PIN_EXP2_INT);
}

// Initialization

void expander_init(void) {
  // Initialize interrupt input pins
  expander_init_int_pins();

  // Initialize expander 1 (buttons 0-15 + display reset)
  mcp23017_init(&g_expander[0], GPIO_EXP1_ADDR);
  // Initialize expander 2 (buttons 16-31)
  mcp23017_init(&g_expander[1], GPIO_EXP2_ADDR);

  // Configure expander 1:
  // - Port A: All inputs (buttons 0-7)
  // - Port B: All inputs (buttons 8-15)
  mcp23017_set_direction(&g_expander[0], MCP23017_PORT_A, 0xFF); // All inputs
  mcp23017_set_direction(&g_expander[0], MCP23017_PORT_B, 0xFF); // All inputs

  // Enable pull-ups for button inputs
  mcp23017_set_pullups(&g_expander[0], MCP23017_PORT_A, 0xFF); // All pull-ups
  mcp23017_set_pullups(&g_expander[0], MCP23017_PORT_B, 0xFF); // All pull-ups

  // Configure expander 2:
  // - Port A: All inputs (buttons 16-23)
  // - Port B: Pin 7 output (display_rst), pins 0-6 inputs (buttons 24-30)
  mcp23017_set_direction(&g_expander[1], MCP23017_PORT_A, 0xFF);
  mcp23017_set_direction(&g_expander[1], MCP23017_PORT_B, 0x7F);
  // Enable pull-ups for all buttons
  mcp23017_set_pullups(&g_expander[1], MCP23017_PORT_A, 0xFF);
  mcp23017_set_pullups(&g_expander[1], MCP23017_PORT_B, 0x7F);

  // Set display reset high (inactive, since it's active-low)
  mcp23017_write_pin(&g_expander[1], MCP23017_PORT_B, DISPLAY_RST_PIN, 1);

  // Configure interrupt-on-change for all button pins
  // Compare to previous value (detect any change)
  mcp23017_configure_interrupt(&g_expander[0], MCP23017_PORT_A, 0xFF, 0x00, 0x00);
  mcp23017_configure_interrupt(&g_expander[0], MCP23017_PORT_B, 0xFF, 0x00, 0x00);
  mcp23017_configure_interrupt(&g_expander[1], MCP23017_PORT_A, 0xFF, 0x00, 0x00);
  mcp23017_configure_interrupt(&g_expander[1], MCP23017_PORT_B, 0x7F, 0x00, 0x00); // Exclude pin 7
}

uint32_t expander_read_buttons(void) {
  uint16_t exp1_raw, exp2_raw;
  uint16_t buttons_low, buttons_high;

  // Read both ports from each expander
  exp1_raw = mcp23017_read_ports(&g_expander[0]);
  exp2_raw = mcp23017_read_ports(&g_expander[1]);

  // Mask out the display reset pin from expander 2 port B
  // Port B is in high byte, mask bit 7
  exp2_raw |= (1 << (8 + DISPLAY_RST_PIN)); // Force bit high (as if not pressed)

  // Invert: buttons are active-low, we want 1 = pressed
  buttons_low = ~exp1_raw;
  buttons_high = ~exp2_raw;

  return ((uint32_t)buttons_high << 16) | buttons_low;
}

uint16_t expander_read_buttons_exp(uint8_t expander) {
  uint16_t raw;

  if (expander > 1)
    return 0;
  raw = mcp23017_read_ports(&g_expander[expander]);
  // Mask display reset pin if reading expander 1
  if (expander == 1)
    raw |= (1 << (8 + DISPLAY_RST_PIN));

  // Invert for active-low buttons
  return ~raw;
}

uint8_t expander_has_interrupt(void) {
  if (!GPIO_READ(PIN_EXP1_INTA))
    return 1;
  if (!GPIO_READ(PIN_EXP1_INTB))
    return 1;
  if (!GPIO_READ(PIN_EXP2_INT))
    return 1;

  return 0;
}

void expander_clear_interrupts(void) {
  // Reading GPIO registers clears the interrupt
  mcp23017_read_ports(&g_expander[0]);
  mcp23017_read_ports(&g_expander[1]);
}

// Display Reset Control

void expander_display_reset_assert(void) {
  mcp23017_write_pin(&g_expander[DISPLAY_RST_EXPANDER], DISPLAY_RST_PORT, DISPLAY_RST_PIN, 0); // Active low
}

void expander_display_reset_release(void) {
  mcp23017_write_pin(&g_expander[DISPLAY_RST_EXPANDER], DISPLAY_RST_PORT, DISPLAY_RST_PIN, 1); // Inactive (high)
}

void expander_display_reset_pulse(uint8_t delay_ms) {
  expander_display_reset_assert();

  // Wait for specified duration
  // Note: Using a loop since _delay_ms requires compile-time constant
  while (delay_ms--)
    _delay_ms(1);

  expander_display_reset_release();
}

// Debug/Test Functions

uint8_t expander_read_raw(uint8_t expander, uint8_t port) {
  if (expander > 1)
    return 0xFF;
  return mcp23017_read_port(&g_expander[expander], port);
}

uint8_t expander_read_intf(uint8_t expander, uint8_t port) {
  if (expander > 1)
    return 0x00;
  return mcp23017_read_interrupt_flag(&g_expander[expander], port);
}

uint8_t expander_read_intcap(uint8_t expander, uint8_t port) {
  if (expander > 1)
    return 0xFF;
  return mcp23017_read_interrupt_capture(&g_expander[expander], port);
}
