rbarbier-p/Harmora/code/src/328p/tasks.h

#ifndef TASKS_H
#define TASKS_H

#include <stdint.h>
#include <stdbool.h>

void task_enable_velocity_reading(bool enabled);
void task_display_velocity(uint8_t key, uint8_t x, uint8_t y);
void task_hall_scan(void);

// Scan 6 rotary encoders via digital mux
void task_encoder_scan(void);

// Handle SPI communication with ATmega32U4
// Send input events, receive display commands
void task_mcu_comm(void);

// Scan 32 buttons via I2C I/O expanders (2x MCP23017)
void task_button_scan(void);

// Scan 4 potentiometers via analog mux
void task_pot_scan(void);

// Update OLED display if framebuffer changed
void task_display_update(void);

// Update LED chain via software SPI
// Only updates if LED state changed
void task_led_update(void);

#endif // TASKS_H
