rbarbier-p/Harmora/code/src/328p/stopwatch.h

#ifndef STOPWATCH_H 
#define STOPWATCH_H 

#include <avr/io.h>
#include <stdint.h>

/**
 * Timer1 profiler
 * Prescaler = 64
 * Tick = 4us (at 16MHz clock)
 * Overflow ≈ 262ms
 * Valid for measurements < 262ms
 */

static inline void stopwatch_init(void) {
    TCCR1A = 0;
    TCCR1B = (1 << CS11) | (1 << CS10); // prescaler = 64
    TCNT1  = 0;
}

static inline uint16_t stopwatch_read(void) {
    return TCNT1;
}

// Calculate elapsed time handling overflow
static inline uint32_t stopwatch_elapsed(uint16_t start, uint16_t end) {
    return ((uint32_t)(uint16_t)(end - start));
    /*
    if (end >= start) {
        return end - start;
    } else {
        return ((0xFFFF - start) + end) * 4;
    }
    */
}

#endif
