rbarbier-p/Harmora/(commit log)

2026-01-18 some footprints and symbols
    [Schematics.kicad_pcb, Schematics.kicad_sch, pcb_schematics.kicad_pcb, pcb_schematics.kicad_sch]
2026-01-18 harmora layout design
    [pcb_schematics.kicad_pcb]
2026-01-19 more symbols
    [piano_subsheet.kicad_sch]
2026-01-21 more schematics
    [SPI_LED_chain.kicad_sch, encoders_mux.kicad_sch, expanders.kicad_sch, hall_sensors.kicad_sch, pcb_schematics.kicad_pcb, pcb_schematics.kicad_sch, piano_poteniometers_mux.kicad_sch]
2026-01-21 repo rearrange
    [Harmora.kicad_pcb, MCU_328p.kicad_sch, SPI_LED_chain.kicad_sch, analog_mux.kicad_sch, digital_mux.kicad_sch, expanders.kicad_sch, pcb_schematics.kicad_sch]
2026-01-22 display, crystal, 32u4<->328p
    [MCU_328p.kicad_sch, MCU_32u4.kicad_sch]
2026-01-22 new schematics
    [Harmora.kicad_pcb, Harmora.kicad_sch, MCU_32u4.kicad_sch, SPI_LED_chain.kicad_sch, analog_mux.kicad_sch, digital_mux.kicad_sch, expanders.kicad_sch]
2026-01-23 USBC & ESD protection
    [MCU_32u4.kicad_sch]
2026-01-25 ISP ports, RESET lines, MIDI DIN 5
    [Harmora.kicad_sch, MCU_32u4.kicad_sch, SPI_LED_chain.kicad_sch, analog_mux.kicad_sch, digital_mux.kicad_sch, expanders.kicad_sch]
2026-01-29 led chain
    [Harmora.kicad_pcb, Harmora.kicad_sch, MCU_32u4.kicad_sch, analog_mux.kicad_sch]
2026-01-30 pcb: piano done
    [Harmora.kicad_pcb, Harmora.kicad_sch, MCU_32u4.kicad_sch, SPI_LED_chain.kicad_sch, analog_mux.kicad_sch]
2026-01-30 longahh day
    [Harmora.kicad_pcb, Harmora.kicad_sch, digital_mux.kicad_sch, expanders.kicad_sch]
2026-01-31 pc is being
    [Harmora.kicad_pcb, Harmora.kicad_sch, digital_mux.kicad_sch, expanders.kicad_sch]
2026-02-02 PCB V1.0 DONE
    [Harmora.kicad_pcb, Harmora.kicad_sch, MCU_32u4.kicad_sch, digital_mux.kicad_sch, expanders.kicad_sch]
2026-02-03 last double-checks
    [Harmora.kicad_pcb, Harmora.kicad_sch]
2026-02-03 vias on pads fixed
    [Harmora.kicad_pcb]
2026-03-07 SPI lib, ssd1309 driver, opencode joined the chat
2026-03-09 programming using only usb c cable working
2026-03-09 readme with improvement for pcb
2026-03-09 arduino uno makefile, better display lib includes
2026-03-12 lowpass filter values changed, dummy adc read
2026-03-13 corrected pinout for DISPLAY_DR, more debug
    [interrupts.c, interrupts.h, mcp23017.c, tasks.c]
2026-03-13 i2c checking status
2026-03-14 fixed the splitted libraries
    [SPI.c, SPI.h, SoftSPI.c, SoftSPI.h]
2026-03-14 might need pull ups on the encoders AnBs
2026-03-15 testing encoders, might need optimization code
2026-03-17 reading hall sensors
2026-03-17 centralized pin abstraction system
2026-03-25 implemented MOS and led handling
2026-04-11 finished reworking pcb
    [Harmora.kicad_pcb, Harmora.kicad_sch, MCU_32u4.kicad_sch, SPI_LED_chain.kicad_sch, analog_mux.kicad_sch, digital_mux.kicad_sch, expanders.kicad_sch]
2026-04-12 remane tag V2
    [Harmora.kicad_pcb]
2026-04-13 MCU_INT to proper pin, VCC to ISP port
    [Harmora.kicad_pcb, Harmora.kicad_sch, MCU_32u4.kicad_sch, SPI_LED_chain.kicad_sch, analog_mux.kicad_sch, digital_mux.kicad_sch, expanders.kicad_sch]
2026-04-18 32u4 interrupt problem 328p hanging, (commented out)
    [atmega328p.c, interrupts.c, tasks.c]
2026-04-21 bidirectional SPI communication MCU-MCU done
2026-04-22 proper communication, in real time button testing, needs button maping, exp1 not working
    [atmega328p.c, harmony_resolver.c, main.c, mcu_comm.c, mcu_comm.h, mcu_link.c]
2026-04-24 exp1 working, remapped buttons
2026-04-28 started implementation of velocity reading for piano keys
2026-04-28 screen overlays, need to work on mux encoder presses
2026-04-30 uploaded first 3Dmodels, key transposition, bass mode
    [case-bottom.stl, case-top.dxf, inner_separators.stl, switch_grid-looper.stl, switch_grid-modes.stl, switch_grid-modifier.stl, switch_grid-piano.stl]
2026-05-02 old velocity reading when doing make
2026-05-02 fixed scene.previous routing when timeout
    [screen_engine.c, screen_engine.h, ui.c, ui.h]
2026-05-02 deleted input_tracker, improved select encoders return
2026-05-02 timer based velocity -> not working
    [atmega328p.c, input_state.c, input_state.h, main.c, tasks.c, tasks.h]
2026-05-03 extender buttons double-tap and hold features
2026-05-03 new ui leds, needs checking before writing on dirty_mask
2026-05-04 ui leds rework
2026-05-04 file rework led ui
    [harmony_resolver.c, leds.h, screens.c, ui.c, ui.h, ui_leds.c]
2026-05-04 velocity ok, debug code
2026-05-04 velocity ready to merge
2026-05-04 added settings to turn off velocity
2026-05-04 corrected velocity bug
2026-05-04 corrected init value for buttons 22, 23, 24
    [input_state.c, input_state.h, main.c, mcu_comm.c, midi.h, ui.c, ui.h]
